ryanoderkirk/SeniorDesign_PillsDispenser/README.md

# Archived Project

This repository is now archived. We have graduated, and we are no longer maintaining this project. Please use it for reference! It may be outdated, or not actively supported.

---
