ryanoderkirk/SeniorDesign_PillsDispenser/Core/Src/main.c

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
/* Includes ------------------------------------------------------------------*/
#include "main.h"
#include "cmsis_os2.h"
#include "app_st67w6x.h"


RTC_HandleTypeDef hrtc;

SPI_HandleTypeDef hspi1;
SPI_HandleTypeDef hspi4;
DMA_HandleTypeDef handle_GPDMA1_Channel1;
DMA_HandleTypeDef handle_GPDMA1_Channel0;

UART_HandleTypeDef huart3;

/* USER CODE BEGIN PV */
osMutexId_t flashMutex;

const osMutexAttr_t flashMutex_attributes = {
  "flashMutex",                          // Name
  osMutexRecursive | osMutexPrioInherit, // Attributes
  NULL,                                  // Memory for control block
  0U                                     // Size of control block
};

/* USER CODE END PV */

void SystemClock_Config(void);
void MX_FREERTOS_Init(void);
static void MX_GPIO_Init(void);
static void MX_GPDMA1_Init(void);
static void MX_USART3_UART_Init(void);
static void MX_SPI4_Init(void);
static void MX_RTC_Init(void);
static void MX_SPI1_Init(void);
/* USER CODE BEGIN PFP */

int initFlashMutex(void);
/* USER CODE END PFP */

/**
  * @brief  The application entry point.
  * @retval int
  */
int main(void)
{

  /* MCU Configuration--------------------------------------------------------*/

  /* Reset of all peripherals, Initializes the Flash interface and the Systick. */
  HAL_Init();

  /* Configure the system clock */
  SystemClock_Config();

  /* Initialize all configured peripherals */
  MX_GPIO_Init();
  MX_GPDMA1_Init();
  MX_USART3_UART_Init();
  MX_SPI4_Init();
  MX_RTC_Init();
  MX_SPI1_Init();
  MX_ST67W6X_Init();
  /* USER CODE BEGIN 2 */
  initFlashMutex();

  //filetest();
  /* USER CODE END 2 */

  /* Init scheduler */
  osKernelInitialize();
  /* Call init function for freertos objects (in app_freertos.c) */
  MX_FREERTOS_Init();

  /* Start scheduler */
  osKernelStart();

  /* We should never get here as control is now taken by the scheduler */

  /* Infinite loop */
  /* USER CODE BEGIN WHILE */
  while (1)
  {
    /* USER CODE END WHILE */

    /* USER CODE BEGIN 3 */
  }
  /* USER CODE END 3 */
}

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
/* USER CODE BEGIN 4 */

RTC_HandleTypeDef* getRTCHandle() {
  return &hrtc;
}

SPI_HandleTypeDef* getFlashSPIHandle() {
  return &hspi1;
}


int initFlashMutex(void) {
  flashMutex = osMutexNew(&flashMutex_attributes);
    if (flashMutex == NULL) {
        return -1;
    }
  return 0;
}

osMutexId_t* getFlashMutex() {
  return &flashMutex;
}

void get_rtc_timestamp(char *buffer) {
    RTC_TimeTypeDef gTime;
    RTC_DateTypeDef gDate;

    // 1. Read Time FIRST (Locks shadow registers)
    HAL_RTC_GetTime(&hrtc, &gTime, RTC_FORMAT_BIN);

    // 2. Read Date SECOND (Unlocks shadow registers)
    HAL_RTC_GetDate(&hrtc, &gDate, RTC_FORMAT_BIN);

    // 3. Format as YYMMDDHHMMSS
    sprintf(buffer, "%02d%02d%02d%02d%02d%02d",
            gDate.Year, gDate.Month, gDate.Date,
            gTime.Hours, gTime.Minutes, gTime.Seconds);
}

void get_rtc_typedef(RTC_DateTypeDef *date, RTC_TimeTypeDef *time) {
  HAL_RTC_GetTime(&hrtc, time, RTC_FORMAT_BIN);
  HAL_RTC_GetDate(&hrtc, date, RTC_FORMAT_BIN);
}

void get_rtc_YYMMDD(char *buffer) {
    RTC_TimeTypeDef gTime;
    RTC_DateTypeDef gDate;

    // 1. Read Time FIRST (Locks shadow registers)
    HAL_RTC_GetTime(&hrtc, &gTime, RTC_FORMAT_BIN);

    // 2. Read Date SECOND (Unlocks shadow registers)
    HAL_RTC_GetDate(&hrtc, &gDate, RTC_FORMAT_BIN);

    // 3. Format as YYMMDD
    sprintf(buffer, "%02d%02d%02d",
            gDate.Year , gDate.Month, gDate.Date);
}


void get_rtc_HHMMSS(char *buffer) {
    RTC_TimeTypeDef gTime;
    RTC_DateTypeDef gDate;

    // 1. Read Time FIRST (Locks shadow registers)
    HAL_RTC_GetTime(&hrtc, &gTime, RTC_FORMAT_BIN);

    // 2. Read Date SECOND (Unlocks shadow registers)
    HAL_RTC_GetDate(&hrtc, &gDate, RTC_FORMAT_BIN);

    // 3. Format as YYMMDD
    sprintf(buffer, "%02d%02d%02d",
            gTime.Hours, gTime.Minutes, gTime.Seconds);
}

void update_system_time(int y, int m, int d, int hh, int mm, int ss) {
    RTC_TimeTypeDef sTime = {0};
    RTC_DateTypeDef sDate = {0};

    // 1. Configure Time
    sTime.Hours = (uint8_t)hh;
    sTime.Minutes = (uint8_t)mm;
    sTime.Seconds = (uint8_t)ss;
    sTime.DayLightSaving = RTC_DAYLIGHTSAVING_NONE;
    sTime.StoreOperation = RTC_STOREOPERATION_RESET;
    HAL_RTC_SetTime(&hrtc, &sTime, RTC_FORMAT_BIN);

    // 2. Configure Date
    sDate.Year = (uint8_t)(y - 2000); // 2026 -> 26
    sDate.Month = (uint8_t)m;
    sDate.Date = (uint8_t)d;
    sDate.WeekDay = RTC_WEEKDAY_SATURDAY; // You can calculate this, but HAL requires a value
    HAL_RTC_SetDate(&hrtc, &sDate, RTC_FORMAT_BIN);
}
/* USER CODE END 4 */

/**
  * @brief  Period elapsed callback in non blocking mode
  * @note   This function is called  when TIM1 interrupt took place, inside
  * HAL_TIM_IRQHandler(). It makes a direct call to HAL_IncTick() to increment
  * a global variable "uwTick" used as application time base.
  * @param  htim : TIM handle
  * @retval None
  */
void HAL_TIM_PeriodElapsedCallback(TIM_HandleTypeDef *htim)
{
  if (htim->Instance == TIM1)
  {
    HAL_IncTick();
  }
}

/**
  * @brief  This function is executed in case of error occurrence.
  * @retval None
  */
void Error_Handler(void)
{
  /* USER CODE BEGIN Error_Handler_Debug */
  /* User can add his own implementation to report the HAL error return state */
  __disable_irq();
  while (1)
  {
  }
  /* USER CODE END Error_Handler_Debug */
}
#ifdef USE_FULL_ASSERT
/**
  * @brief  Reports the name of the source file and the source line number
  *         where the assert_param error has occurred.
  * @param  file: pointer to the source file name
  * @param  line: assert_param error line source number
  * @retval None
  */
void assert_failed(uint8_t *file, uint32_t line)
{
  /* USER CODE BEGIN 6 */
  /* User can add his own implementation to report the file name and line number,
     ex: printf("Wrong parameters value: file %s on line %d\r\n", file, line) */
  /* USER CODE END 6 */
}
#endif /* USE_FULL_ASSERT */
