ryanoderkirk/SeniorDesign_PillsDispenser/STM32CubeIDE.ioc

Mcu.UserName=STM32H563ZITx
PA0.Signal=ADCx_INP0
PA1.Signal=ADCx_INP1
PA10.GPIO_Label=WIFI_BOOT
PA10.Signal=GPIO_Output
PA11.GPIO_Label=WIFI_CHIP_EN
PA11.Signal=GPIO_Output
PA12.GPIO_Label=WIFI_SPI_RDY
PA12.Signal=GPXTI12
PA15(JTDI).Signal=S_TIM2_CH1
PA2.Signal=S_TIM2_CH3
PA3.Signal=S_TIM2_CH4
PA6.Signal=ADCx_INP3
PA7.Signal=ADCx_INP7
PA9.GPIO_Label=WIFI_SPI_CS
PA9.Signal=GPIO_Output
PB1.Signal=ADCx_INP5
PB10.GPIO_Label=LCD_SCK
PB10.Signal=SPI2_SCK
PB12.GPIO_Label=FINGERPRINT_UART_RX
PB12.Signal=UART5_RX
PB13.GPIO_Label=FINGERPRINT_UART_TX
PB13.Signal=UART5_TX
PB2.GPIO_Label=WIFI_MOSI
PB2.Signal=SPI3_MOSI
PB3(JTDO/TRACESWO).Signal=S_TIM2_CH2
PC0.GPIO_Label=LCD_CS
PC0.Signal=GPIO_Output
PC1.GPIO_Label=LCD_MOSI
PC1.Signal=SPI2_MOSI
PC10.GPIO_Label=WIFI_SCK
PC10.Signal=SPI3_SCK
PC11.GPIO_Label=WIFI_MISO
PC11.Signal=SPI3_MISO
PC13.GPIO_Label=WIFI2_SPI_RDY
PC13.Signal=GPXTI13
PC14-OSC32_IN(OSC32_IN).GPIO_Label=WIFI2_CHIP_EN
PC14-OSC32_IN(OSC32_IN).Signal=GPIO_Output
PC15-OSC32_OUT(OSC32_OUT).GPIO_Label=WIFI2_BOOT
PC15-OSC32_OUT(OSC32_OUT).Signal=GPIO_Output
PC2.GPIO_Label=LCD_MISO
PC2.Signal=SPI2_MISO
PC3.GPIO_Label=LCD_DC
PC3.Signal=GPIO_Output
PC4.Signal=ADCx_INP4
PD1.GPIO_Label=WIFI_UART_TX
PD1.Signal=UART4_TX
PD11.GPIO_Label=WIFI_UART_RX
PD11.Signal=UART4_RX
PD12.Signal=S_TIM4_CH1
PD13.Signal=S_TIM4_CH2
PD7.GPIO_Label=Flash_MOSI
PD7.Signal=SPI1_MOSI
PD8.GPIO_Label=DEBUG_USART_TX
PD8.Signal=USART3_TX
PD9.GPIO_Label=DEBUG_USART_RX
PD9.Signal=USART3_RX
PE11.GPIO_Label=POWER_INT
PE11.Signal=GPXTI11
PE2.GPIO_Label=WIFI2_SPI4_SCK
PE2.Signal=SPI4_SCK
PE4.GPIO_Label=WIFI2_SPI_CS
PE4.Signal=GPIO_Output
PE5.GPIO_Label=WIFI2_SPI4_MISO
PE5.Signal=SPI4_MISO
PE6.GPIO_Label=WIFI2_SPI4_MOSI
PE6.Signal=SPI4_MOSI
PF0.GPIO_Label=SELECT
PF0.Signal=GPXTI0
PF1.GPIO_Label=BACK
PF1.Signal=GPXTI1
PF11.Signal=ADC1_INP2
PF14.Signal=ADC2_INP6
PF2.GPIO_Label=ENCA
PF2.Signal=GPXTI2
PF3.GPIO_Label=ENCB
PF3.Signal=GPIO_Input
PF6.GPIO_Label=WIFI2_UART_RX
PF6.Signal=UART7_RX
PF7.GPIO_Label=WIFI2_UART_TX
PF7.Signal=UART7_TX
PG11.GPIO_Label=Flash_SCK
PG11.Signal=SPI1_SCK
PG12.GPIO_Label=Flash_CS
PG12.Signal=GPIO_Output
PG9.GPIO_Label=Flash_MISO
PG9.Signal=SPI1_MISO
PH1-OSC_OUT(PH1).GPIO_Label=LCD_RST
PH1-OSC_OUT(PH1).Signal=GPIO_Output
