ryanoderkirk/SeniorDesign_PillsDispenser/Core/Src/app_freertos.c

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

/* Includes ------------------------------------------------------------------*/
#include "app_freertos.h"

/* USER CODE BEGIN Includes */

#include "logging.h"
#include "filesystem.h"
/* USER CODE END Includes */

/* Definitions for defaultTask */
osThreadId_t defaultTaskHandle;
const osThreadAttr_t defaultTask_attributes = {
  .name = "defaultTask",
  .priority = (osPriority_t) osPriorityAboveNormal4,
  .stack_size = 1024 * 4
};

/**
  * @brief  FreeRTOS initialization
  * @param  None
  * @retval None
  */
void MX_FREERTOS_Init(void) {
  /* USER CODE BEGIN RTOS_MUTEX */
  /* add mutexes, ... */
  /* USER CODE END RTOS_MUTEX */

  /* USER CODE BEGIN RTOS_SEMAPHORES */
  /* add semaphores, ... */
  /* USER CODE END RTOS_SEMAPHORES */

  /* USER CODE BEGIN RTOS_TIMERS */
  /* start timers, add new ones, ... */
  /* USER CODE END RTOS_TIMERS */

  /* USER CODE BEGIN RTOS_QUEUES */
  /* add queues, ... */
  /* USER CODE END RTOS_QUEUES */
  /* creation of defaultTask */
  defaultTaskHandle = osThreadNew(StartDefaultTask, NULL, &defaultTask_attributes);

  /* USER CODE BEGIN RTOS_THREADS */
  /* add threads, ... */
  /* USER CODE END RTOS_THREADS */

  /* USER CODE BEGIN RTOS_EVENTS */
  /* add events, ... */
  /* USER CODE END RTOS_EVENTS */

}
/* USER CODE BEGIN Header_StartDefaultTask */
/**
* @brief Function implementing the defaultTask thread.
* @param argument: Not used
* @retval None
*/
/* USER CODE END Header_StartDefaultTask */
void StartDefaultTask(void *argument)
{
  /* USER CODE BEGIN defaultTask */
    LogEntry_t log;
    fillLogTimestamp(&log);

    if (filesystemInit() != 0) {
      LogError("Filesystem init failed\n");
    }
    if (initDailyLog() != 0) {
      LogError("Could not write log file\n");
    }
    deleteAllLogs();
  /* Infinite loop */
  for(;;)
  {

    listLogFiles();

    osDelay(10000);
  }
  /* USER CODE END defaultTask */
}
