ryanoderkirk/SeniorDesign_PillsDispenser/(commit log)

2026-02-14 Generate STM32 project
2026-02-17 Add pins for LCD SPI control and buttons
2026-02-18 Improve pin naming
2026-02-18 Add power interrupt
2026-02-19 Add wifi uart. Add WiFi backup pinset
2026-02-27 fix code generation and build
    [PillsDispenser.ioc, main.c, main.h]
2026-02-27 Configure sample http server example
2026-02-27 Add middleware and drivers. Fix build
    [PillsDispenser.ioc, app_freertos.c]
2026-03-01 Try to map to less busy pins on dev kit. Enable EXTI7 interrupt
2026-03-01 Remove all non WiFi subsystem pin assignments
2026-03-01 Remap SPI_RDY from user button to fix init failure
    [PillsDispenser.ioc, main.c, main.h]
2026-03-01 Remove unused testing WiFi pin mappings
2026-03-02 Revert "Remove unused testing WiFi pin mappings"
    Accidentally started working on main
    This reverts commit de0a9e3fc1f4fd4c107e3351641a221d5acd22de.
    [PillsDispenser.ioc, main.c, main.h]
2026-03-03 Increase stack space allocated by FreeRTOS to avoid LittleFS stack overflow
    [app_freertos.c]
2026-03-04 Clear rx buffer when transmitting SPI data'
2026-03-04 Add error logs to flash driver commands
    [filesystem.c]
2026-03-09 Fix GET /logs error response. Remove unused EXTI interrupt
    [PillsDispenser.ioc, main.c, main.h]
2026-03-09 Fix get time functions. Add better http error responses. Add deleteAllLogs on startup for testing
    [app_freertos.c, main.c]
2026-03-09 Correct config file initialization. Add doses file along with readDoses writeDosage function stubs
    [filesystem.c, filesystem.h]
